relyd/modbussniffer/modbussniffer-setup.png

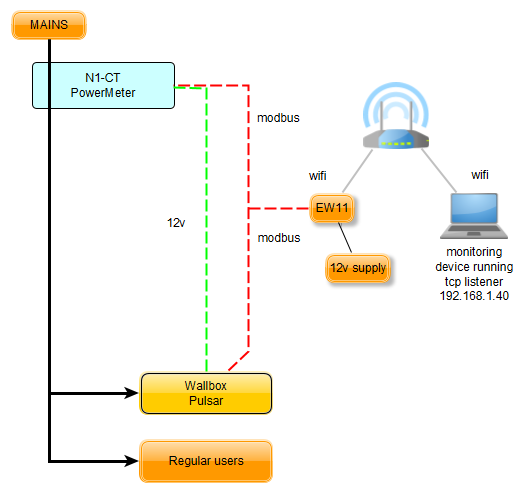
modbussniffer-setup.png
