relyd/modbussniffer/(commit log)

2023-06-04 Update readme.md
    explained voltage/power
2023-06-13 Update esp8266sniffer.ino
    added sample response
